penma/avr-pci/board/megapci3.brd

## EAGLE design board/megapci3.brd (2015-12-18)

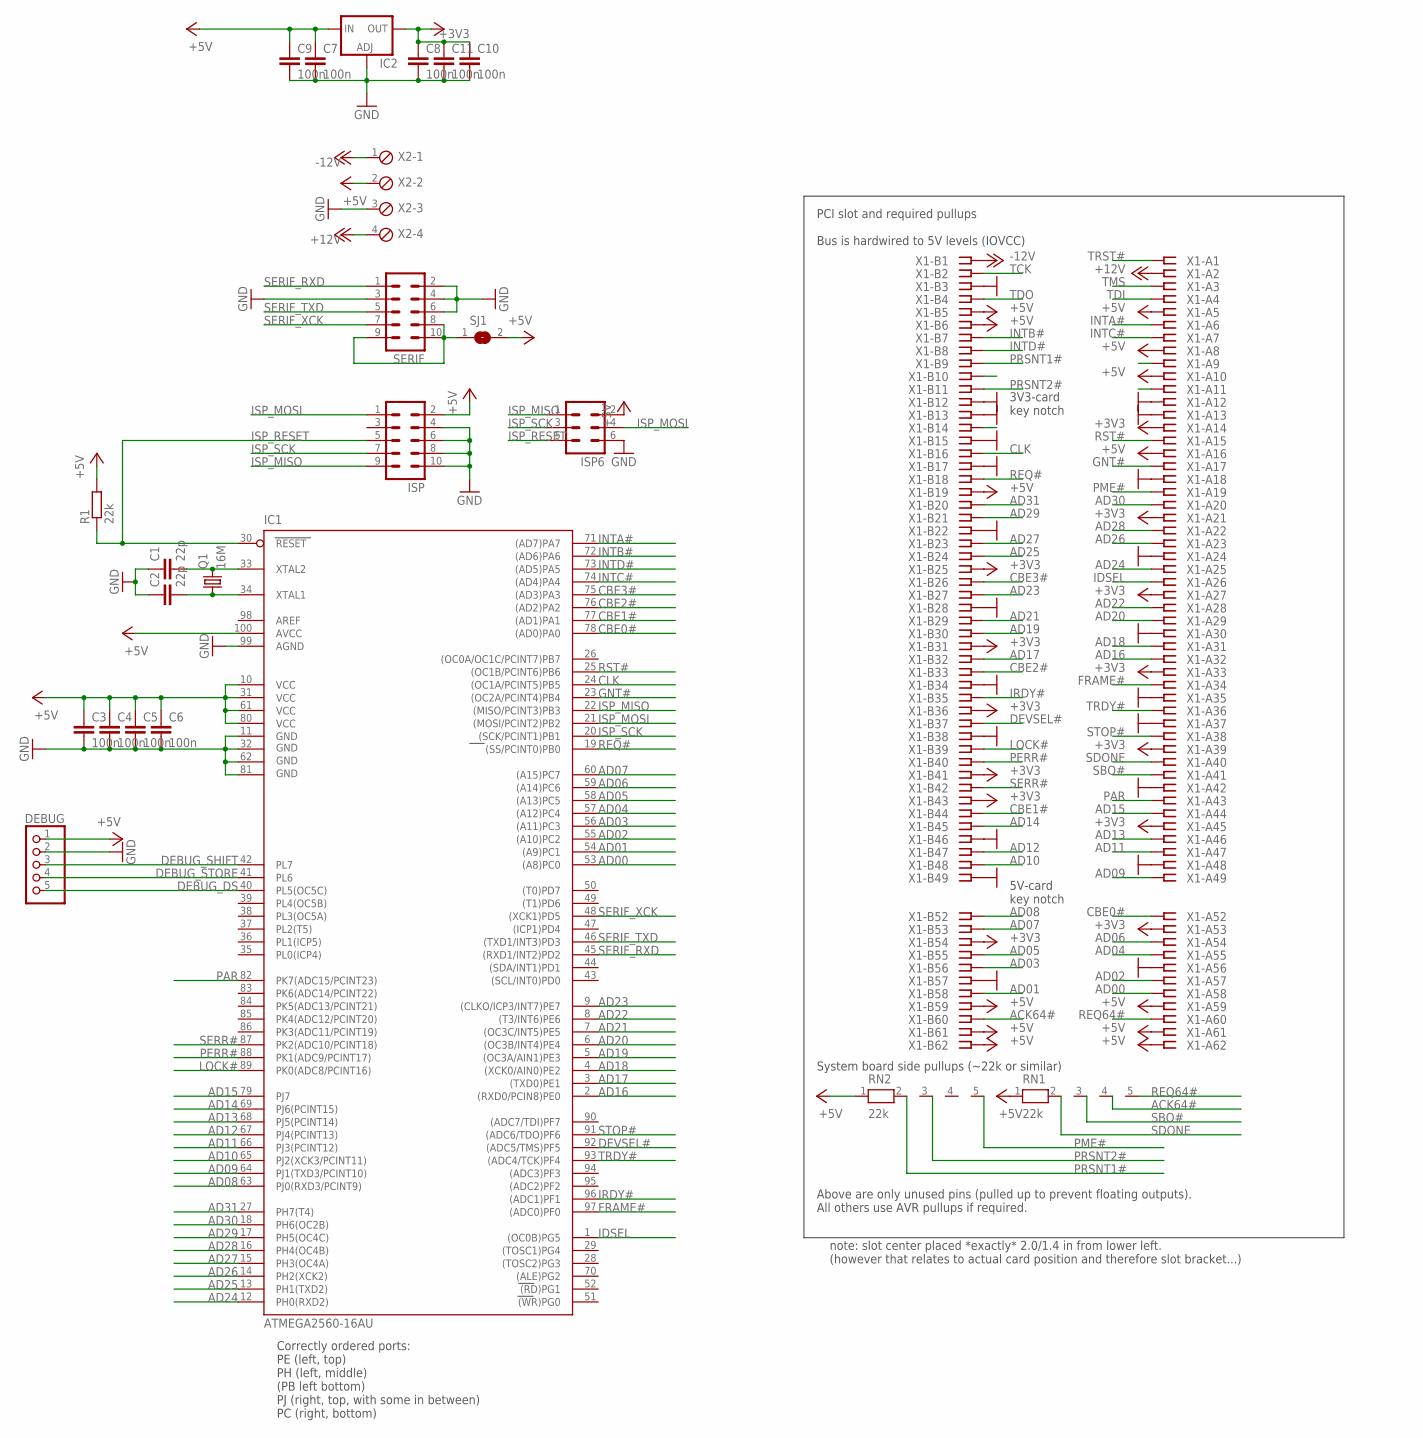
[picture p1: schematic megapci3.sch]

Parts:
C1, C2: 22p; C0805
C3, C4, C5, C6, C7, C8, C9, C10, C11: 100n; C0805
DEBUG: PINHD-1X5; 1X05
IC1: ATMEGA2560-16AU; TQFP100
IC2: LM317TS; 317TS
ISP: ML10
ISP6: ML6
Q1: 16M; HC49/S
R1: 22k; R0805
RN1, RN2: 22k; RN-5
SERIF: ML10
SJ1: SJ
X1: PCI-SLOT; CON-PCI
X2: MPT4; 4POL254

Connections:
5V-SER: SERIF.8, SERIF.9, SERIF.10, SJ1.1
+3V3: C8.1, C10.1, C11.1, IC2.2 (OUT), X1.A14, X1.A21, X1.A27, X1.A33, X1.A39, X1.A45, X1.A53, X1.B25, X1.B31, X1.B36, X1.B41, X1.B43, X1.B54
+5V: C3.1, C4.1, C5.1, C6.1, C7.1, C9.1, DEBUG.1, IC1.10 (VCC), IC1.31 (VCC1), IC1.61 (VCC2), IC1.80 (VCC3), IC1.100 (AVCC), IC2.3 (IN), ISP.2, ISP6.2, R1.2, RN1.1, RN2.1, SJ1.2, X1.A5, X1.A8, X1.A10, X1.A16, X1.A59, X1.A61, X1.A62, X1.B5, X1.B6, X1.B19, X1.B59, X1.B61, X1.B62, X2.2
+12V: X1.A2, X2.4
-12V: X1.B1, X2.1
ACK64#: RN1.4, X1.B60
AD00: IC1.53 ((A8)PC0), X1.A58
AD01: IC1.54 ((A9)PC1), X1.B58
AD02: IC1.55 ((A10)PC2), X1.A57
AD03: IC1.56 ((A11)PC3), X1.B56
AD04: IC1.57 ((A12)PC4), X1.A55
AD05: IC1.58 ((A13)PC5), X1.B55
AD06: IC1.59 ((A14)PC6), X1.A54
AD07: IC1.60 ((A15)PC7), X1.B53
AD08: IC1.63 (PJ0(RXD3/PCINT9)), X1.B52
AD09: IC1.64 (PJ1(TXD3/PCINT10)), X1.A49
AD10: IC1.65 (PJ2(XCK3/PCINT11)), X1.B48
AD11: IC1.66 (PJ3(PCINT12)), X1.A47
AD12: IC1.67 (PJ4(PCINT13)), X1.B47
AD13: IC1.68 (PJ5(PCINT14)), X1.A46
AD14: IC1.69 (PJ6(PCINT15)), X1.B45
AD15: IC1.79 (PJ7), X1.A44
AD16: IC1.2 ((RXD0/PCIN8)PE0), X1.A32
AD17: IC1.3 ((TXD0)PE1), X1.B32
AD18: IC1.4 ((XCK0/AIN0)PE2), X1.A31
AD19: IC1.5 ((OC3A/AIN1)PE3), X1.B30
AD20: IC1.6 ((OC3B/INT4)PE4), X1.A29
AD21: IC1.7 ((OC3C/INT5)PE5), X1.B29
AD22: IC1.8 ((T3/INT6)PE6), X1.A28
AD23: IC1.9 ((CLKO/ICP3/INT7)PE7), X1.B27
AD24: IC1.12 (PH0(RXD2)), X1.A25
AD25: IC1.13 (PH1(TXD2)), X1.B24
AD26: IC1.14 (PH2(XCK2)), X1.A23
AD27: IC1.15 (PH3(OC4A)), X1.B23
AD28: IC1.16 (PH4(OC4B)), X1.A22
AD29: IC1.17 (PH5(OC4C)), X1.B21
AD30: IC1.18 (PH6(OC2B)), X1.A20
AD31: IC1.27 (PH7(T4)), X1.B20
CBE0#: IC1.78 ((AD0)PA0), X1.A52
CBE1#: IC1.77 ((AD1)PA1), X1.B44
CBE2#: IC1.76 ((AD2)PA2), X1.B33
CBE3#: IC1.75 ((AD3)PA3), X1.B26
CLK: IC1.24 ((OC1A/PCINT5)PB5), X1.B16
DEBUG_DS: DEBUG.5, IC1.40 (PL5(OC5C))
DEBUG_SHIFT: DEBUG.3, IC1.42 (PL7)
DEBUG_STORE: DEBUG.4, IC1.41 (PL6)
DEVSEL#: IC1.92 ((ADC5/TMS)PF5), X1.B37
FRAME#: IC1.97 ((ADC0)PF0), X1.A34
GND: C1.1, C2.1, C3.2, C4.2, C5.2, C6.2, C7.2, C8.2, C9.2, C10.2, C11.2, DEBUG.2, IC1.11 (GND), IC1.32 (GND1), IC1.62 (GND2), IC1.81 (GND3), IC1.99 (AGND), IC2.1 (ADJ), ISP.4, ISP.6, ISP.8, ISP.10, ISP6.6, SERIF.2, SERIF.3, SERIF.4, SERIF.6, X1.A12, X1.A13, X1.A18, X1.A24, X1.A30, X1.A35, X1.A37, X1.A42, X1.A48, X1.A56, X1.B3, X1.B12, X1.B13, X1.B15, X1.B17, X1.B22, X1.B28, X1.B34, X1.B38, X1.B46, X1.B49, X1.B57, X2.3
GNT#: IC1.23 ((OC2A/PCINT4)PB4), X1.A17
IDSEL: IC1.1 ((OC0B)PG5), X1.A26
INTA#: IC1.71 ((AD7)PA7), X1.A6
INTB#: IC1.72 ((AD6)PA6), X1.B7
INTC#: IC1.74 ((AD4)PA4), X1.A7
INTD#: IC1.73 ((AD5)PA5), X1.B8
IRDY#: IC1.96 ((ADC1)PF1), X1.B35
ISP_MISO: IC1.22 ((MISO/PCINT3)PB3), ISP.9, ISP6.1
ISP_MOSI: IC1.21 ((MOSI/PCINT2)PB2), ISP.1, ISP6.4
ISP_RESET: IC1.30 (RESET), ISP.5, ISP6.5, R1.1
ISP_SCK: IC1.20 ((SCK/PCINT1)PB1), ISP.7, ISP6.3
LOCK#: IC1.89 (PK0(ADC8/PCINT16)), X1.B39
unnamed: C1.2, IC1.33 (XTAL2), Q1.2
unnamed: C2.2, IC1.34 (XTAL1), Q1.1
PAR: IC1.82 (PK7(ADC15/PCINT23)), X1.A43
PERR#: IC1.88 (PK1(ADC9/PCINT17)), X1.B40
PME#: RN2.5, X1.A19
PRSNT1#: RN2.2, X1.B9
PRSNT2#: RN2.3, X1.B11
REQ64#: RN1.5, X1.A60
REQ#: IC1.19 ((SS/PCINT0)PB0), X1.B18
RST#: IC1.25 ((OC1B/PCINT6)PB6), X1.A15
RSVD1: X1.A9
RSVD2: X1.A11
RSVD3: X1.B10
RSVD4: X1.B14
SBO#: RN1.3, X1.A41
SDONE: RN1.2, X1.A40
SERIF_RXD: IC1.45 ((RXD1/INT2)PD2), SERIF.1
SERIF_TXD: IC1.46 ((TXD1/INT3)PD3), SERIF.5
SERIF_XCK: IC1.48 ((XCK1)PD5), SERIF.7
SERR#: IC1.87 (PK2(ADC10/PCINT18)), X1.B42
STOP#: IC1.91 ((ADC6/TDO)PF6), X1.A38
TCK: X1.B2
TDI: X1.A4
TDO: X1.B4
TMS: X1.A3
TRDY#: IC1.93 ((ADC4/TCK)PF4), X1.A36
TRST#: X1.A1

Notes on the sheet:
3V3-card key notch
5V-card key notch
PCI slot and required pullups Bus is hardwired to 5V levels (IOVCC)
System board side pullups (~22k or similar)
Above are only unused pins (pulled up to prevent floating outputs). All others use AVR pullups if required.
Correctly ordered ports: PE (left, top) PH (left, middle) (PB left bottom) PJ (right, top, with some in between) PC (right, bottom)
note: slot center placed *exactly* 2.0/1.4 in from lower left. (however that relates to actual card position and therefore slot bracket...)

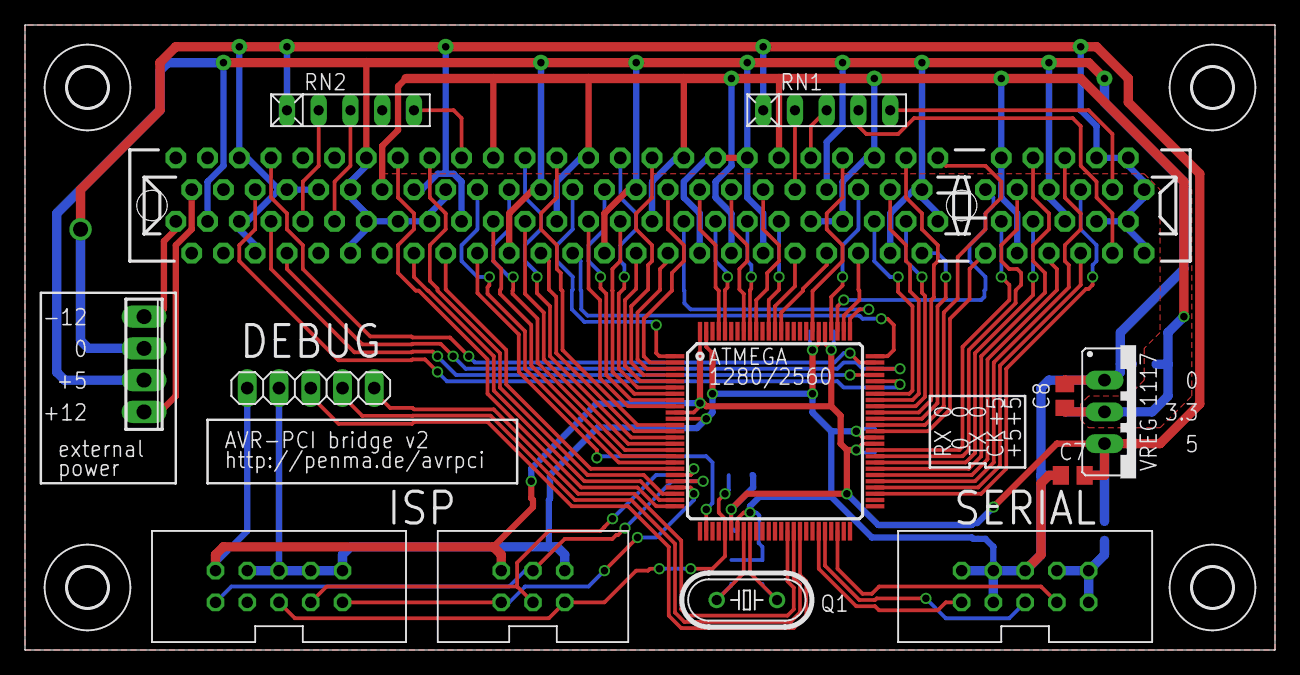
[picture p2: board megapci3.brd from above]

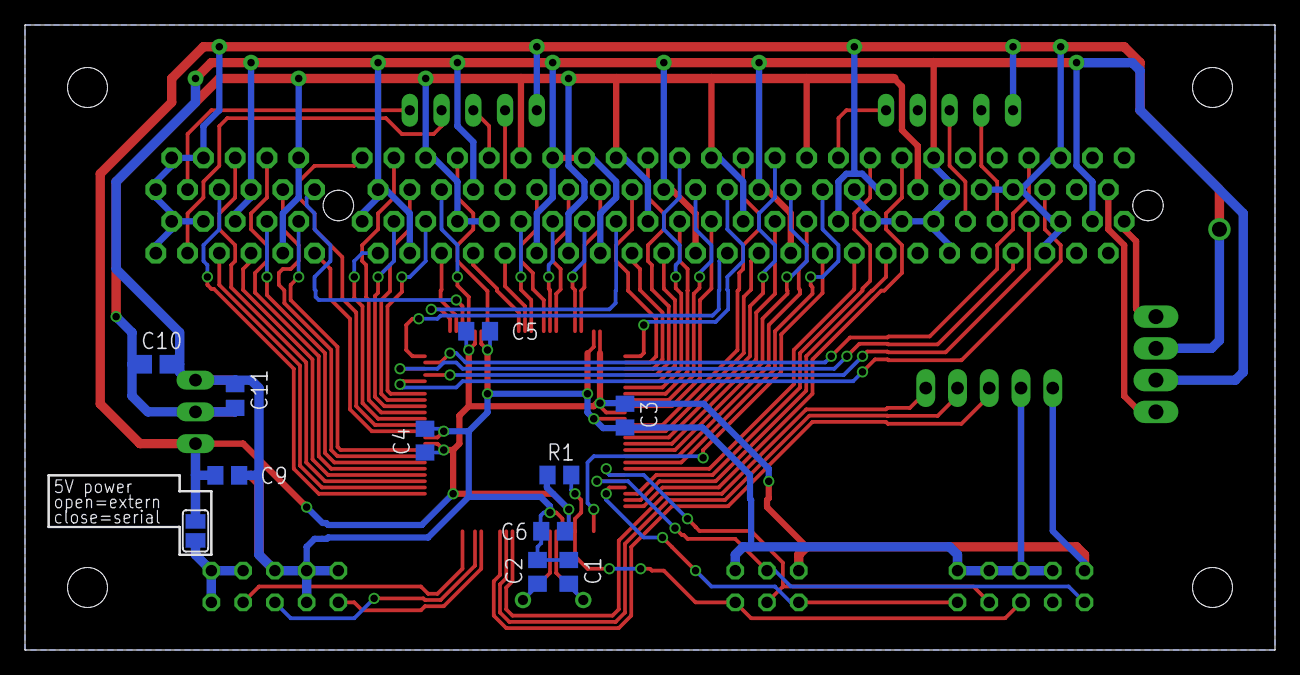
[picture p3: board megapci3.brd from below]

Board: 2 copper layers, 100.0 x 50.0 mm, 28 parts (11 on the bottom side), 79 nets.

Other parts of the board:
U$1, U$2, U$3, U$4: 3,2
