penma/avr-pci/(commit log)

2015-12-20 make IDSEL always high
    As we only have a single slot and IDSEL is just for identifying one of
    many slots during configuration transactions (and otherwise ignored) we
    can just permanently select the one and only IDSEL line.
2015-12-21 Timer 3 can now be used for benchmarking
    Use TCNT3 to get a cycle counter
2015-12-22 improved device identification
2015-12-24 inform us when device requests the bus
2015-12-25 bugfix; move PCI parts to subdir; start rtl8169 driver
    bugfix: GNT# was driven as if it was GNT. That is, actually granting the
    card the bus all the time. This obviously causes the card to do funny things
    when it sees its GNT# asserted and someone else is on the bus...
    [commands.h, console.c, console.h, main.c, master_transaction.c, master_transaction.h, panic.c]
2015-12-25 separate pci identification into its own "driver"
2016-01-11 various changes
    * start of rtl8139 driver
    * debug port moved to ISP port (hardware SPI not used because the SS pin is
    used, which prevents proper SPI master operation)
    * identify more PCI devices
    * timer-controlled PCI clock when no transaction is active (some chips need
    an active clock or they stop doing anything at all)
    [debug.c, lspci.c, main.c, master_transaction.c, mii.h, pci.c, pci.h, rtl8139.c]
